peternagy96/nixie_clock/(threads)

Thread 1 (2020-02-03):

Rotate Nixie tubes 180° on the PCB board

peternagy96, 2020-02-03:
The Nixie tubes are facing in the wrong direction, so they should be rotated on the board and the Gerber files should be saved and uploaded again.

Closed 2020-02-16.

Thread 2 (2020-02-03):

Opto-coupler model should be replaced on the PCB design

peternagy96, 2020-02-03:
The current model of the opto-coupler is too large. The actual opto-coupler's connections are too small to be properly souldered onto the board.

Closed 2020-02-16.

Thread 3 (2020-02-03):

Add VCC and GND pins for the RTC

peternagy96, 2020-02-03:
The current PCB design does not have these pins. The orientation of the RTC should also be taken into account.

Closed 2020-02-16.

Thread 4 (2020-02-03):

Use new connector pin models

peternagy96, 2020-02-03:
The current connector pin models are too small - the actual connectors barely fit, so their PCB model should be replaced.

Closed 2020-02-16.

Thread 5 (2020-02-03):

Add holes ot the PCB to attach the 200V power converter

peternagy96, 2020-02-03:
Having holes drilled in the PCB would make mounting the power converter to the PCB easier, as now it has to be glued in place.

Closed 2020-02-16.

Thread 11 (2020-02-16):

replace holes at the corners with bigger ones

peternagy96, 2020-02-16:

Closed 2020-02-16.

Thread 7 (2020-02-16):

correct names on board

peternagy96, 2020-02-16:

Closed 2020-02-16.

Thread 8 (2020-02-16):

replace K_DOT resistor to 56k

peternagy96, 2020-02-16:

Closed 2020-02-16.
