peternagy96/nixie_clock/board/nixie_clock.brd

## EAGLE design board/nixie_clock.brd (2020-10-24)

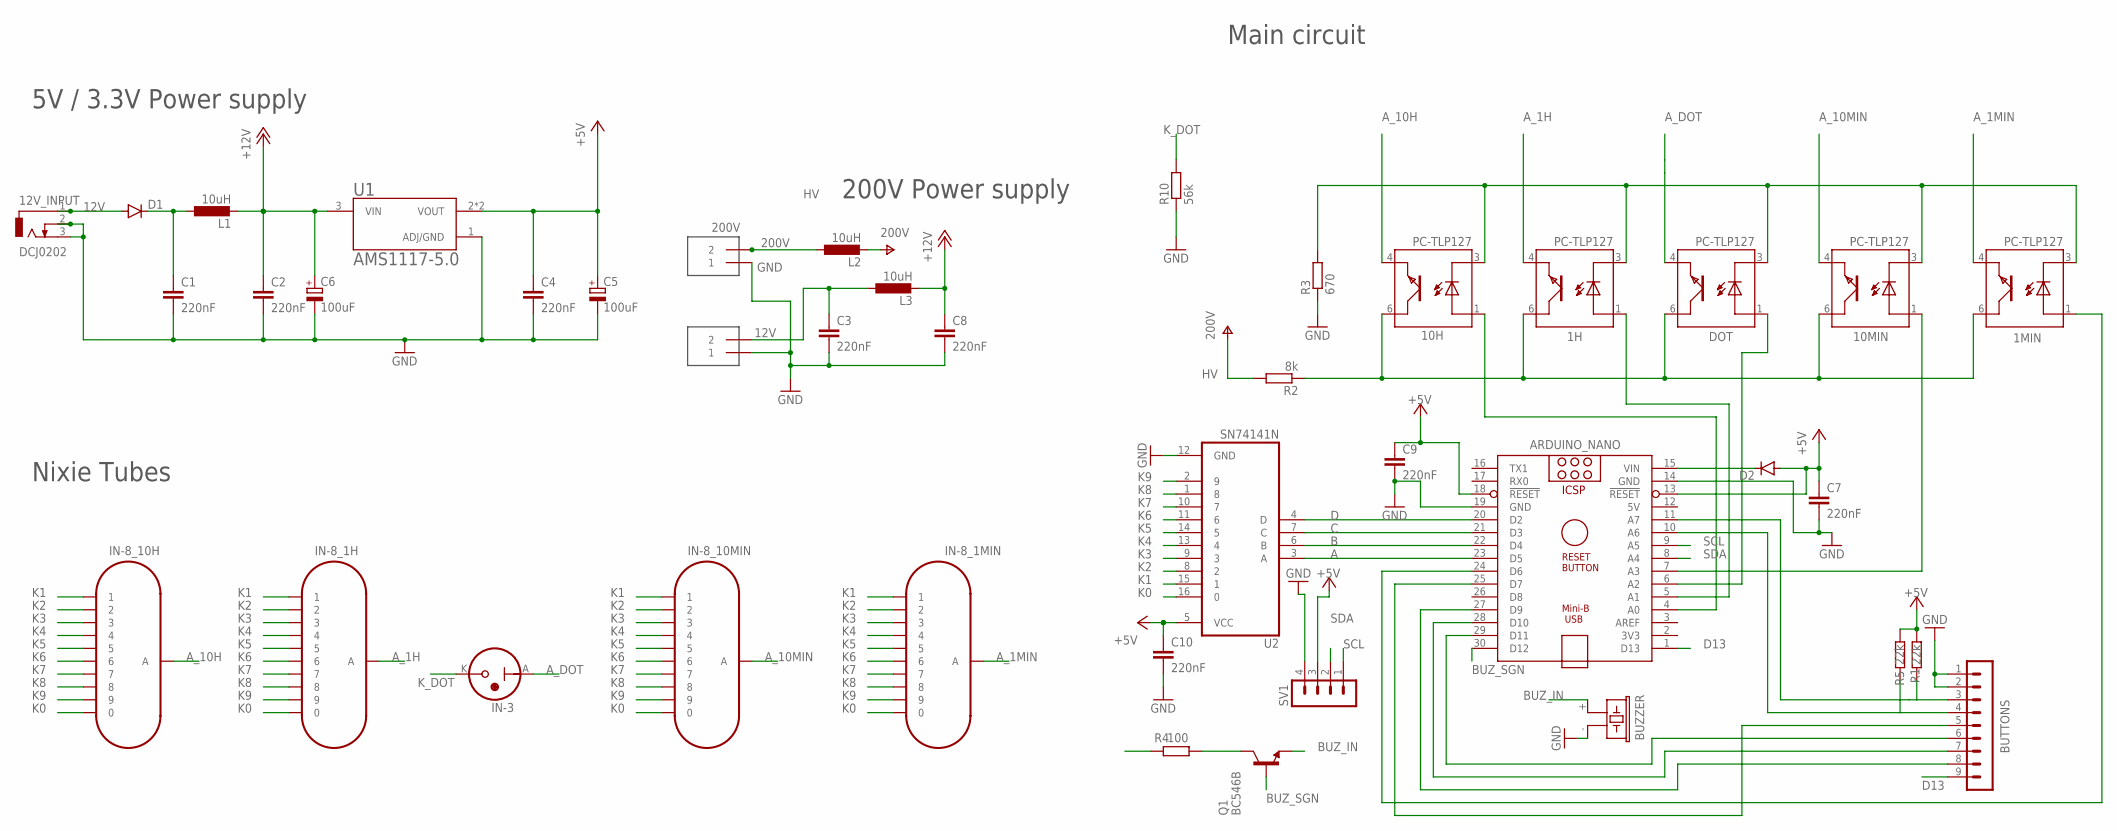
[picture p1: schematic nixie_clock.sch]

Parts:
1H, 1MIN, 10H, 10MIN: PC-TLP127; MINIFLAT4
12V, 200V: TERMINAL_2P; KF301-2P
12V_INPUT: DCJ0202
ARDUINO_NANO: ARDUINO_NANO
BUTTONS: MA09-1
BUZZER: F/CM12P
C1, C2, C3, C4, C7, C8, C9, C10: 220nF; C2.5-3
C5, C6: 100uF; E2,5-6E
D1, D2: 1N4148DO35-7; DO35-7
DOT: PC-TLP127; MINIFLAT4
IN-3: IN-3
IN-8_1H, IN-8_1MIN, IN-8_10H, IN-8_10MIN: IN-8
L1, L2, L3: 10uH; 0204/7
Q1: BC546B; TO92-EBC
R1, R5: 22k; 0204/7
R2: 8k; 0204/7
R3: 670; 0204/7
R4: 100; 0204/7
R10: 56k; 0204/7
SV1: MA04-1
U1: AMS1117-5.0; SOT229P700X180-4N
U2: SN74141N; DIP762W46P254L2134H508Q16

Connections:
5V: ARDUINO_NANO.12 (5V)
12V: 12V.2, 12V_INPUT.1, C3.1, D1.A, L3.1
200V: 200V.2, L2.1
+5V: ARDUINO_NANO.13 (!RESET), ARDUINO_NANO.18 (!RESET), C4.1, C5.+, C7.1, C9.1, C10.1, D2.A, R1.2, R5.2, SV1.3, U1.2 (VOUT), U1.4 (VOUT), U2.5 (VCC)
+12V: C2.1, C6.+, C8.1, L1.2, L3.2, R4.1, U1.3 (VIN)
A: ARDUINO_NANO.23 (D5), U2.3 (A)
A_1H: 1H.4 (TE), IN-8_1H.A
A_1MIN: 1MIN.4 (TE), IN-8_1MIN.A
A_10H: 10H.4 (TE), IN-8_10H.A
A_10MIN: 10MIN.4 (TE), IN-8_10MIN.A
A_DOT: DOT.4 (TE), IN-3.A
B: ARDUINO_NANO.22 (D4), U2.6 (B)
BUZ_IN: BUZZER.+ (1), Q1.E
BUZ_SGN: ARDUINO_NANO.30 (D12), Q1.B
C: ARDUINO_NANO.21 (D3), U2.7 (C)
D: ARDUINO_NANO.20 (D2), U2.4 (D)
D13: ARDUINO_NANO.1 (D13), BUTTONS.9
GND: 12V.1, 12V_INPUT.2, 12V_INPUT.3, 200V.1, ARDUINO_NANO.14 (GND), ARDUINO_NANO.19 (GND), BUTTONS.1, BUTTONS.2, BUZZER.- (2), C1.2, C2.2, C3.2, C4.2, C5.-, C6.-, C7.2, C8.2, C9.2, C10.2, R3.1, R10.1, SV1.4, U1.1 (ADJ/GND), U2.12 (GND)
HV: L2.2, R2.2
K0: IN-8_1H.0, IN-8_1MIN.0, IN-8_10H.0, IN-8_10MIN.0, U2.16 (0)
K1: IN-8_1H.1, IN-8_1MIN.1, IN-8_10H.1, IN-8_10MIN.1, U2.15 (1)
K2: IN-8_1H.2, IN-8_1MIN.2, IN-8_10H.2, IN-8_10MIN.2, U2.8 (2)
K3: IN-8_1H.3, IN-8_1MIN.3, IN-8_10H.3, IN-8_10MIN.3, U2.9 (3)
K4: IN-8_1H.4, IN-8_1MIN.4, IN-8_10H.4, IN-8_10MIN.4, U2.13 (4)
K5: IN-8_1H.5, IN-8_1MIN.5, IN-8_10H.5, IN-8_10MIN.5, U2.14 (5)
K6: IN-8_1H.6, IN-8_1MIN.6, IN-8_10H.6, IN-8_10MIN.6, U2.11 (6)
K7: IN-8_1H.7, IN-8_1MIN.7, IN-8_10H.7, IN-8_10MIN.7, U2.10 (7)
K8: IN-8_1H.8, IN-8_1MIN.8, IN-8_10H.8, IN-8_10MIN.8, U2.1 (8)
K9: IN-8_1H.9, IN-8_1MIN.9, IN-8_10H.9, IN-8_10MIN.9, U2.2 (9)
K_DOT: IN-3.K, R10.2
unnamed: ARDUINO_NANO.15 (VIN), D2.C
unnamed: C1.1, D1.C, L1.1
unnamed: 1MIN.1 (A), ARDUINO_NANO.24 (D6)
unnamed: ARDUINO_NANO.25 (D7), BUTTONS.5
unnamed: 1H.6 (TC), 1MIN.6 (TC), 10H.6 (TC), 10MIN.6 (TC), DOT.6 (TC), R2.1
unnamed: Q1.C, R4.2
unnamed: ARDUINO_NANO.10 (A6), BUTTONS.4, R5.1
unnamed: ARDUINO_NANO.11 (A7), BUTTONS.3, R1.1
unnamed: 10H.1 (A), ARDUINO_NANO.4 (A0)
unnamed: 1H.3 (C), 1MIN.3 (C), 10H.3 (C), 10MIN.3 (C), DOT.3 (C), R3.2
unnamed: ARDUINO_NANO.29 (D11), BUTTONS.6
unnamed: ARDUINO_NANO.28 (D10), BUTTONS.7
unnamed: ARDUINO_NANO.27 (D9), BUTTONS.8
unnamed: 1H.1 (A), ARDUINO_NANO.5 (A1)
unnamed: ARDUINO_NANO.6 (A2), DOT.1 (A)
unnamed: 10MIN.1 (A), ARDUINO_NANO.7 (A3)
SCL: ARDUINO_NANO.9 (A5), SV1.1
SDA: ARDUINO_NANO.8 (A4), SV1.2

Notes on the sheet:
5V / 3.3V Power supply
200V Power supply
Main circuit
Nixie Tubes

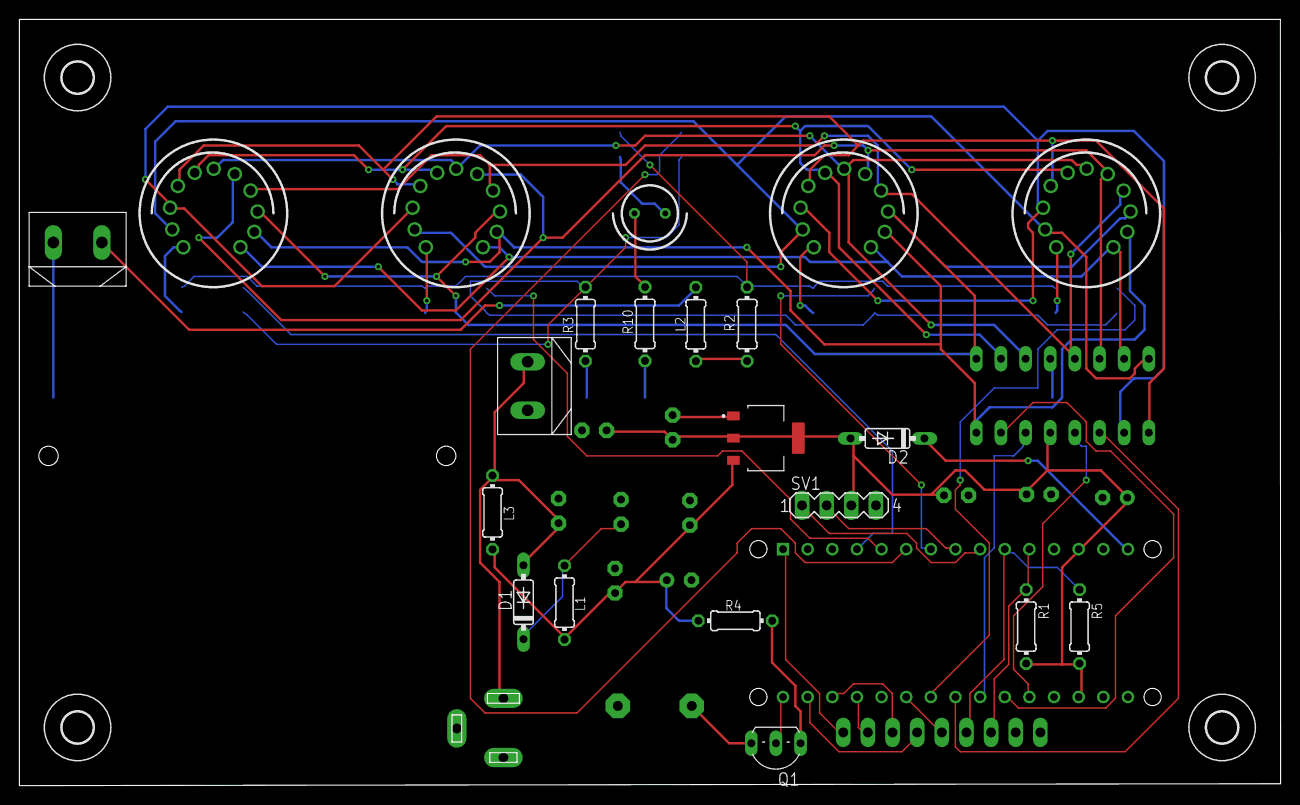
[picture p2: board nixie_clock.brd from above]

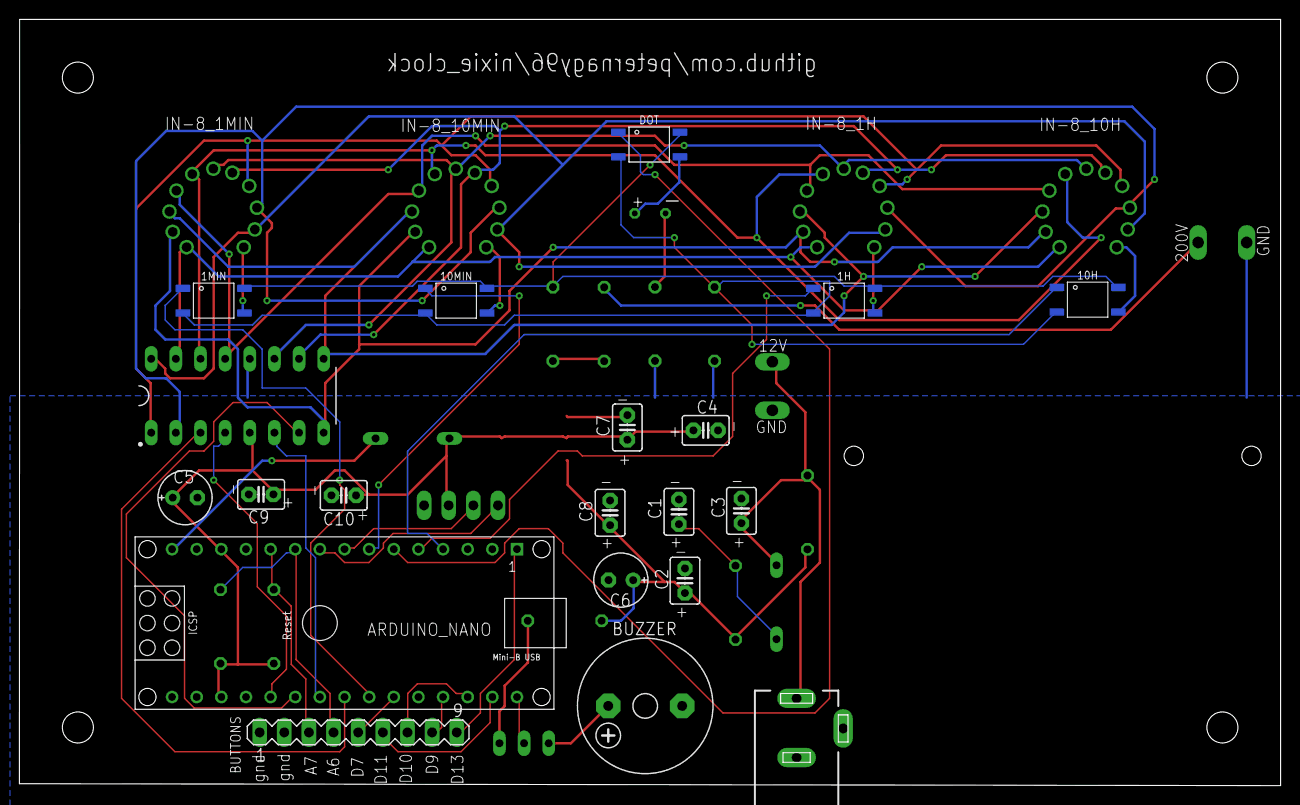
[picture p3: board nixie_clock.brd from below]

Board: 2 copper layers, 130.0 x 79.0 mm, 45 parts (20 on the bottom side), 47 nets.

Other parts of the board:
U$1, U$2, U$3, U$4: 3,2
