peternagy96/nixie_clock/code/TiltSwitch.cpp

/*
* Class for the implementation of the tilt switches
*/

#include "TiltSwitch.h"
#include <Arduino.h>

void TiltSwitchClass::setPin(uint8_t upPin, uint8_t downPin) {
    pinMode(upPin, INPUT_PULLUP);
    this->upPin = upPin;
    pinMode(downPin, INPUT_PULLUP);
    this->downPin = downPin;
}

void TiltSwitchClass::readState(void) {
    if (digitalRead(upPin) == LOW) {
        setToUp();
    } else if (digitalRead(downPin) == LOW) {
        setToDown();
    } else {
        setToMiddle();
    }
}

void TiltSwitchClass::setToUp(void) {
    up = true;
    down = false;
    middle = false;
}

void TiltSwitchClass::setToDown(void) {
    up = false;
    down = true;
    middle = false;
}

void TiltSwitchClass::setToMiddle(void) {
    up = false;
    down = false;
    middle = true;
}

void TiltSwitchClass::incrementHour(ChronoClass* chrono) {
    chrono->incrementHour();
}

void TiltSwitchClass::decrementHour(ChronoClass* chrono) {
    chrono->decrementHour();
}

void TiltSwitchClass::incrementMin(ChronoClass* chrono) {
    chrono->incrementMin();
}

void TiltSwitchClass::decrementMin(ChronoClass* chrono) {
    chrono->decrementMin();
}
