peternagy96/nixie_clock/(commit log)

2020-01-08 added button to D13
    [nixie_clock.brd, nixie_clock.sch]
2020-01-08 finalized board component layout
    [nixie_clock.brd, nixie_clock.sch]
2020-01-08 moved the tubes towards the center
    [nixie_clock.brd]
2020-01-09 ran autorouter with jlcpcb capabilities
    [nixie_clock.brd, nixie_clock.sch]
2020-01-10 board design finalized
    [nixie_clock.brd]
2020-01-10 added gerber file
2020-01-10 final board adjustments
    [nixie_clock.brd]
2020-01-27 added unnecessary board files
2020-01-28 add arduino config files
2020-01-30 fix syntax and include errors
    [Alarm.cpp, Alarm.h, Buzzer.cpp, Buzzer.h, Chrono.h, Nixie.cpp, Nixie.h, PushButton.cpp]
2020-01-30 all compile errors fixed
    [Alarm.cpp, Alarm.h, Chrono.h, Nixie.cpp, Nixie.h, PushButton.cpp, main.ino]
2020-01-31 correct arduino pin numbers
    [main.ino]
2020-01-31 added buzzer and button pins
    [main.ino]
2020-01-31 added tubes test
2020-02-01 check all tubes and numbers
2020-02-01 set arduino pins
2020-02-01 finalized tubes test
2020-02-01 finetuned tube duration
2020-02-03 button test implemented
2020-02-03 added button press mechanism
2020-02-04 update buzzer pin
2020-02-06 timekeeping works - still strange errors when setting time
    [Alarm.cpp, Alarm.h, Buzzer.cpp, Countdown.cpp, Countdown.h, PushButton.cpp, TiltSwitch.h, Timekeeper.cpp]
2020-02-16 PCB redesign
    [nixie_clock.brd, nixie_clock.sch]
2020-02-16 move 200v header
    [nixie_clock.brd]
2020-02-18 D13 pin added and minor placement changes
    [nixie_clock.brd, nixie_clock.sch]
2020-02-19 Diode before Arduino's VIN added
    [nixie_clock.brd, nixie_clock.sch]
2020-02-23 exported gerber of 2nd design
2020-06-14 board design v3
    [nixie_clock.brd, nixie_clock.sch]
2020-06-15 rounded off 90 degree wire turns
    [nixie_clock.brd]
2020-06-17 Connected 12V to buzzer.
    [nixie_clock.brd, nixie_clock.sch]
2020-06-17 Exported board v3 gerber
2020-07-26 added nixie tube testing script.
    [nixie_clock.brd, nixie_clock.sch]
2021-04-24 make sure button presses are not registered in rest mode
2021-04-26 fix floating button
2021-09-05 add pomodoro timer
